mcieslak0111/LED-Heart-Program/LED_Heart_pcb_final.png

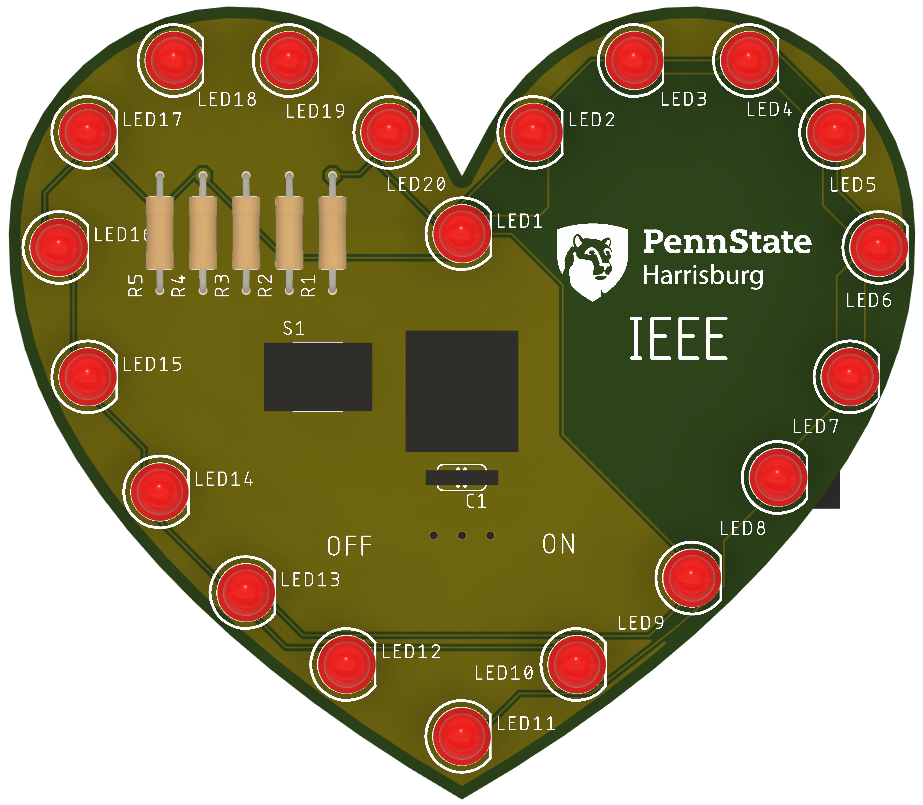
LED_Heart_pcb_final.png
