mcieslak0111/LED-Heart-Program/LED Heart Schematic.pdf

A

A

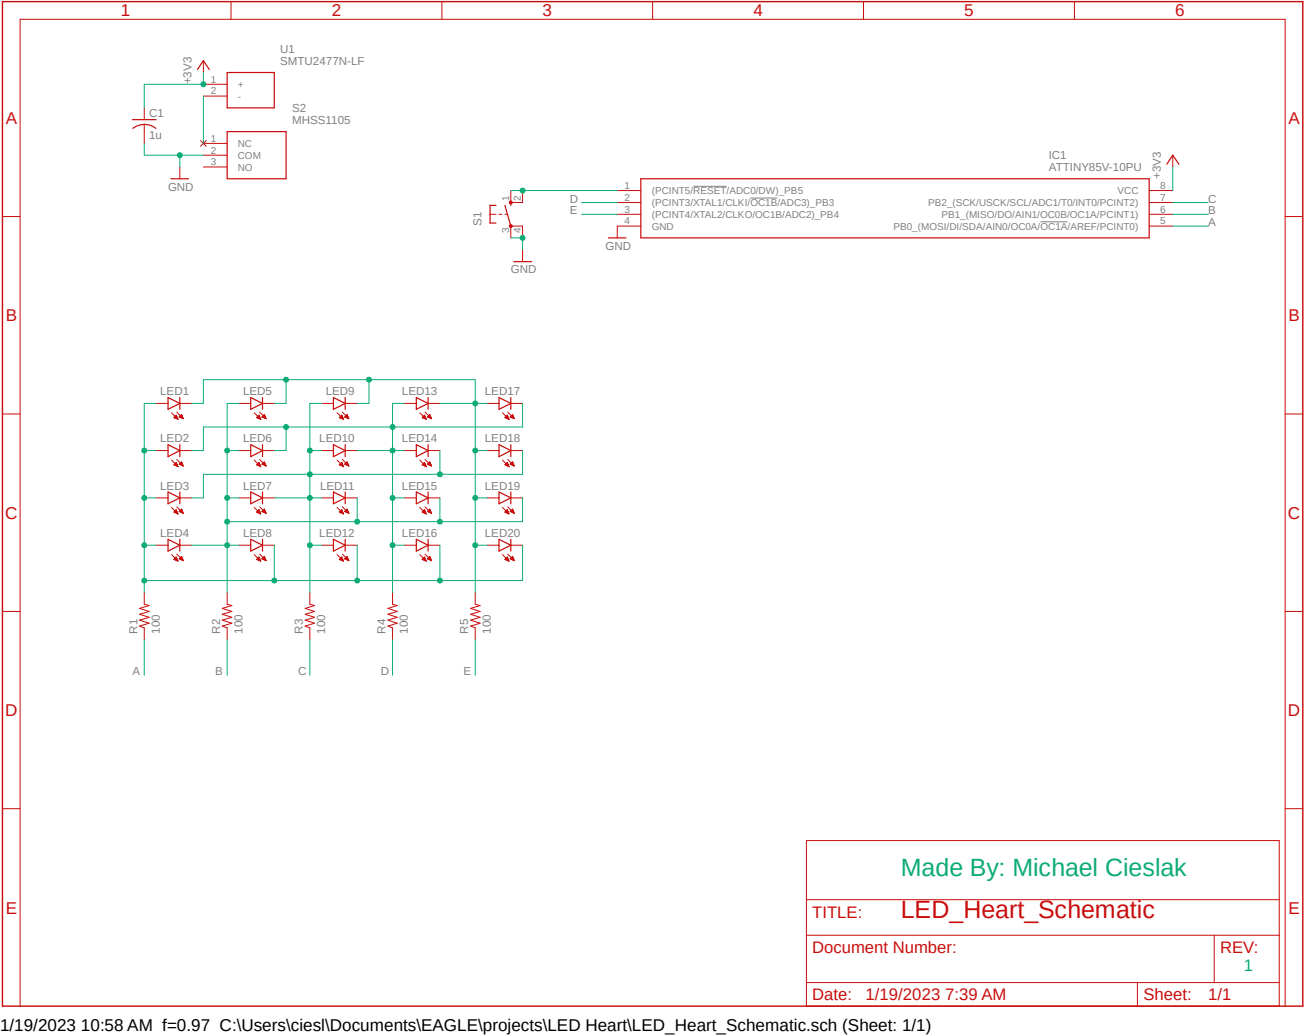
[picture p2: page 1]

LED10 | LED14 | LED18

LED7 | | LED11 | LED15 | LED19

LED8 | | LED12 | | LED16

Made By: Michael Cieslak
LED_Heart_Schematic

Document Number: | REV: 1

Date: 1/19/2023 7:39 AM | Sheet: 1/1

1/19/2023 10:58 AM f=0.97 C:\Users\ciesl\Documents\EAGLE\projects\LED Heart\LED_Heart_Schematic.sch (Sheet: 1/1)
