mcieslak0111/LED-Heart-Program/(commit log)

2023-02-02 Increase brightness, decrease PWM resolution to 8
2023-02-27 Create LED-Heart_Animation
2023-02-27 Update LED-Heart_Animation
